ayu192006/Heat_Exchanger_Drying_System/(list of files, cad)

Other CAD files:
Solar Oven/Assemble for Dryer box.f3d
Solar Oven/Assemble for heater.f3d
Solar Oven/Base Bracket.f3d
Solar Oven/Cold Inlet circular.f3d
Solar Oven/Cold outlet.f3d
Solar Oven/Fan adapter.f3d
Solar Oven/Hot oulet.f3d
Solar Oven/sleeve v2.f3d
