ayu192006/Heat_Exchanger_Drying_System/Solar Oven/PPT.pdf

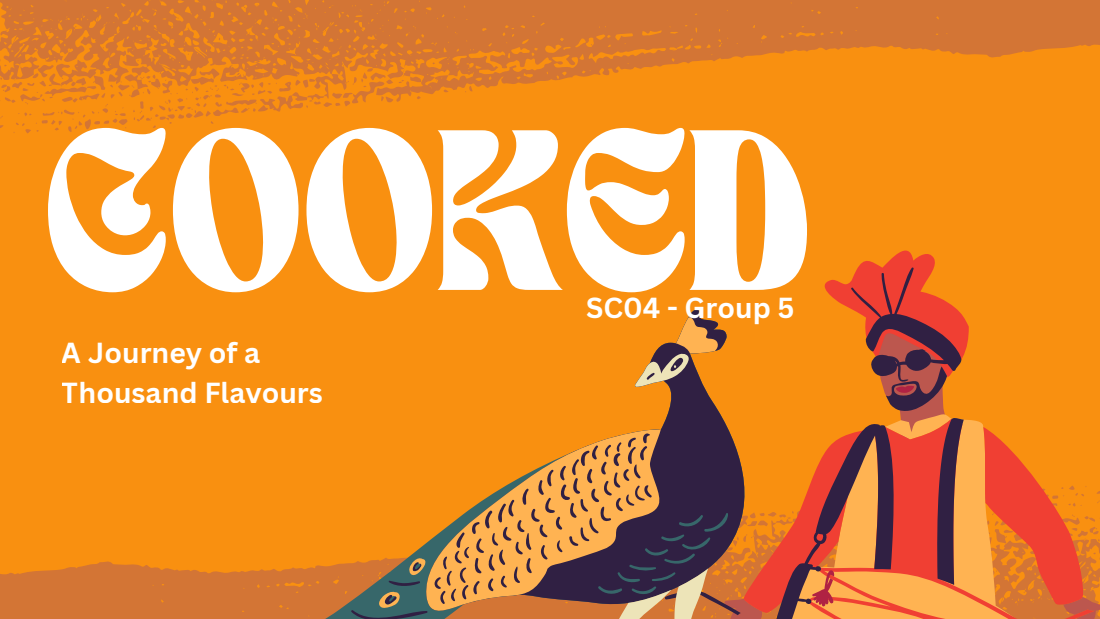
[picture p8: page 1]
Thousand Flavours; SC04 - Group 5

COOKED A Journey of a

# Problem Statement

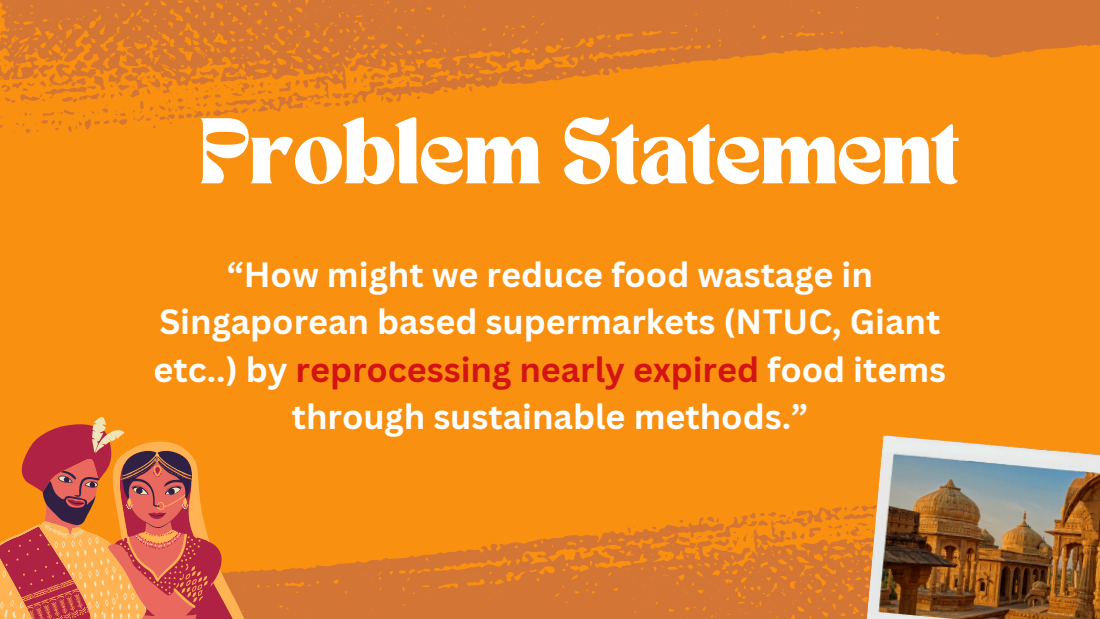
[picture p9: page 2]

“How might we reduce food wastage in
Singaporean based supermarkets (NTUC, Giant
etc..) by reprocessing nearly expired food items

through sustainable methods.

# Food Waste in Supermarket

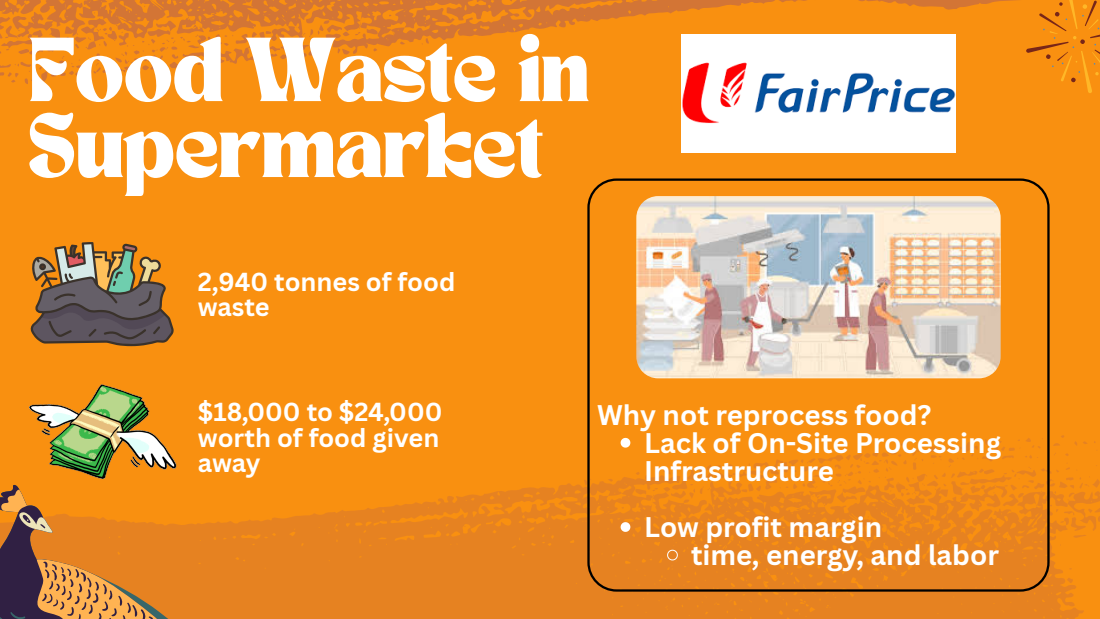
[picture p10: page 3]

2,940 tonnes of food
waste

worth of food given
away

Why not reprocess food?
Lack of On-Site Processing
Infrastructure
Low profit margin
time, energy, and labor

# Prototype

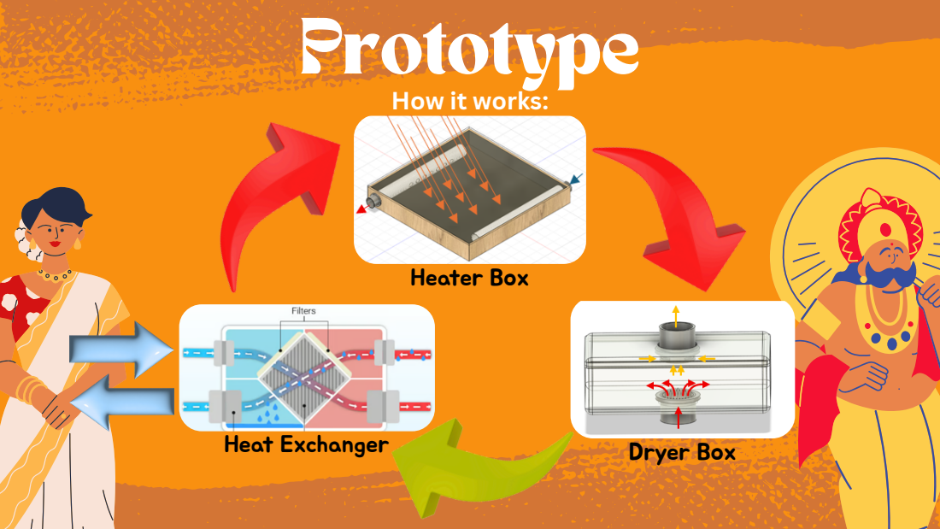
[picture p11: page 4]
Heater Box; Dryer Box; eat Exchanger

How it works:

# Prototype

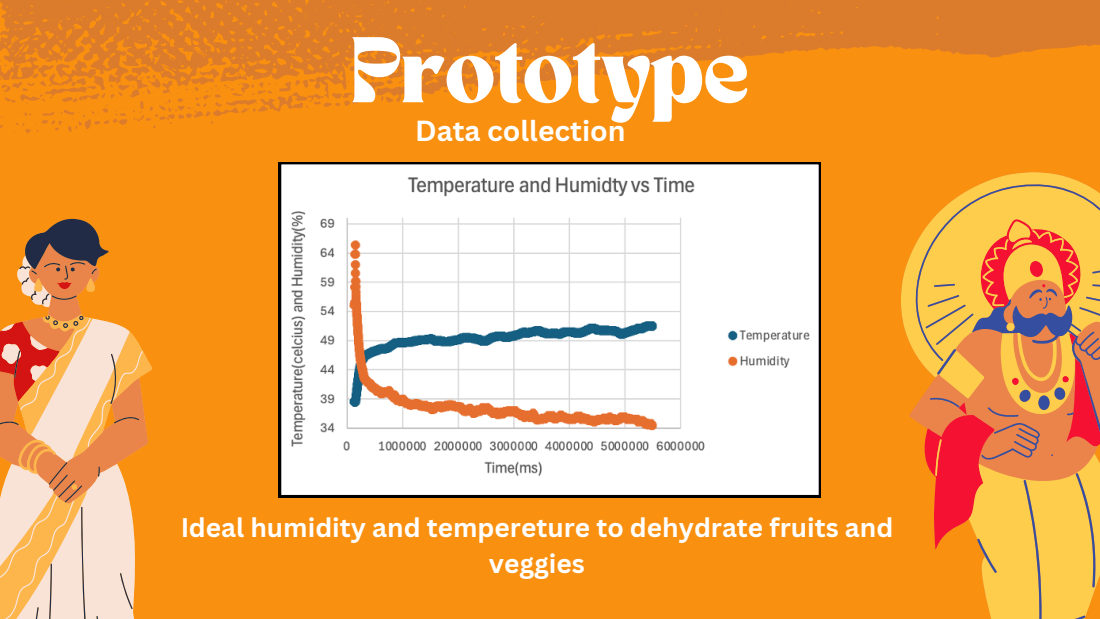
[picture p12: page 5]
Data collection; veggies

Ideal humidity and tempereture to dehydrate fruits and
